wdevbox/synthtar/synth-drawing-4-19-19.PNG

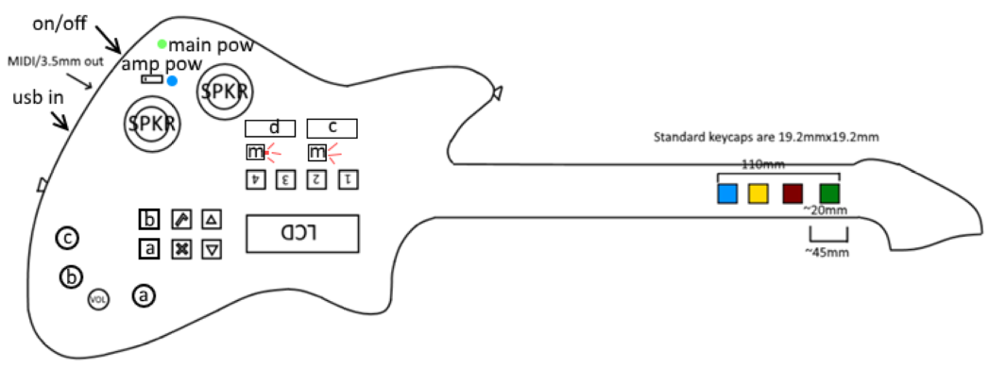
synth-drawing-4-19-19.PNG
