wdevbox/synthtar/Synthtar/Images/overall_schematic.png

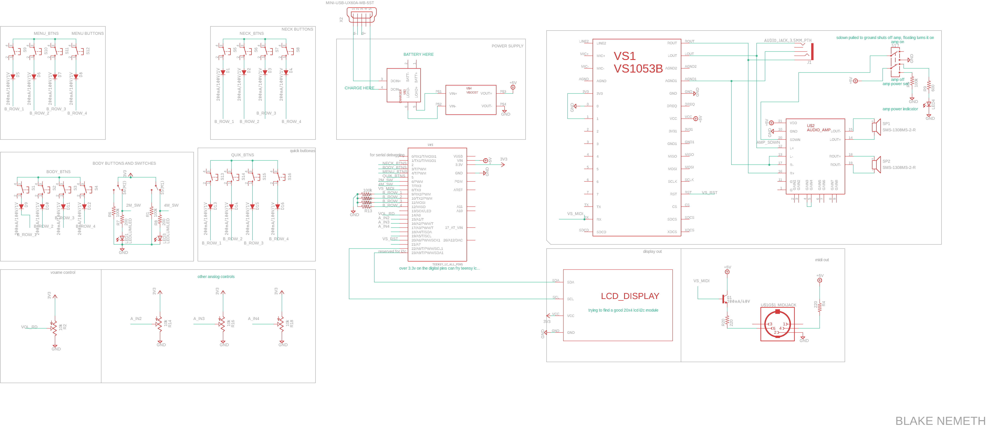
Synthtar/Images/overall_schematic.png
