wdevbox/synthtar/Synthtar/Images/schem_4-19-19-morning.png

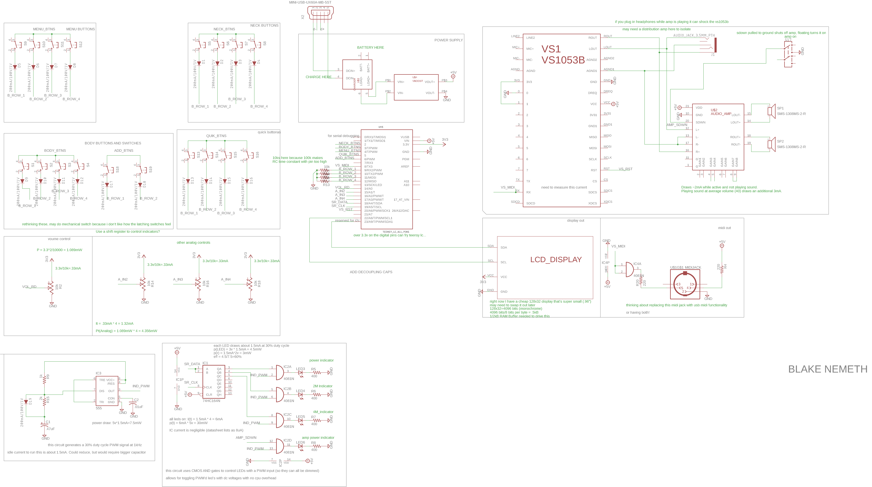
Synthtar/Images/schem_4-19-19-morning.png
