wdevbox/synthtar/Synthtar/analog_inputs.brd

## EAGLE design Synthtar/analog_inputs.brd (2019-05-16)

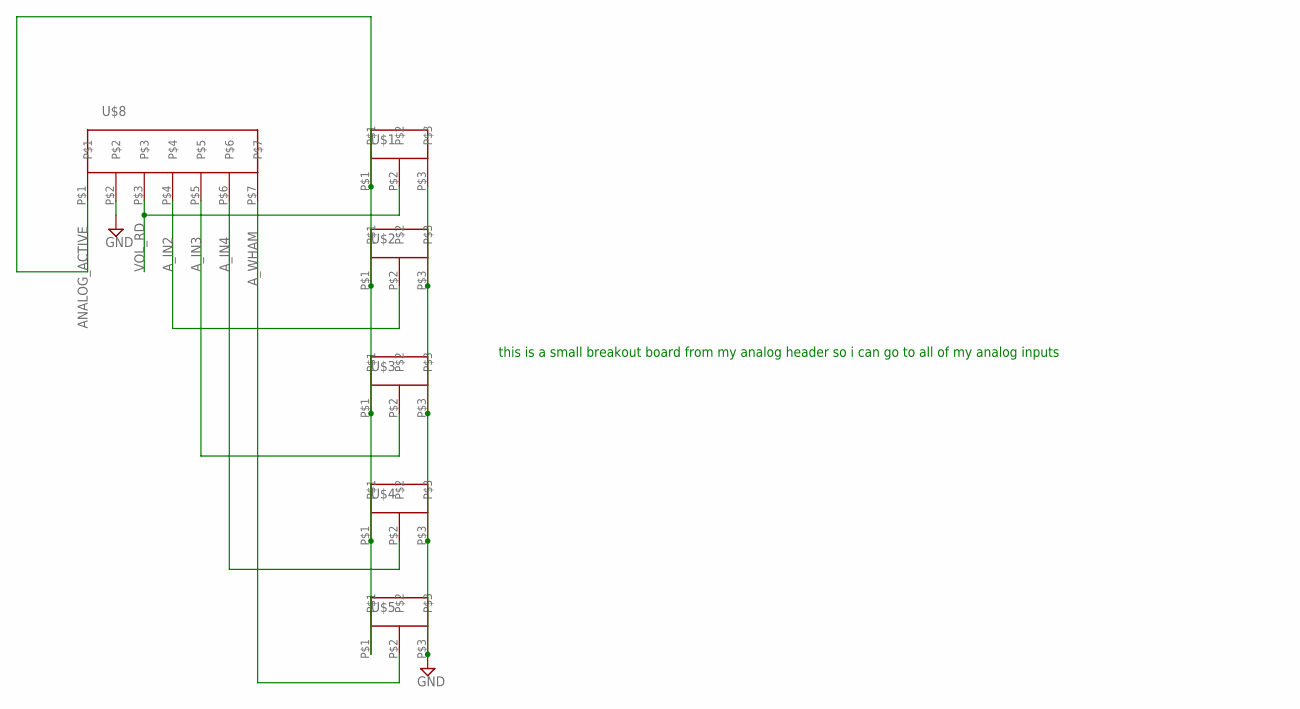
[picture p27: schematic analog_inputs.sch]

Parts:
U$1, U$2, U$3, U$4, U$5: 3-PIN-HEADER
U$8: 7-PIN-HEADER

Connections:
ANALOG_ACTIVE: U$1.P$1, U$2.P$1, U$3.P$1, U$4.P$1, U$5.P$1, U$8.P$1
A_IN2: U$2.P$2, U$8.P$4
A_IN3: U$3.P$2, U$8.P$5
A_IN4: U$4.P$2, U$8.P$6
A_WHAM: U$5.P$2, U$8.P$7
GND: U$1.P$3, U$2.P$3, U$3.P$3, U$4.P$3, U$5.P$3, U$8.P$2
VOL_RD: U$1.P$2, U$8.P$3

Notes on the sheet:
this is a small breakout board from my analog header so i can go to all of my analog inputs

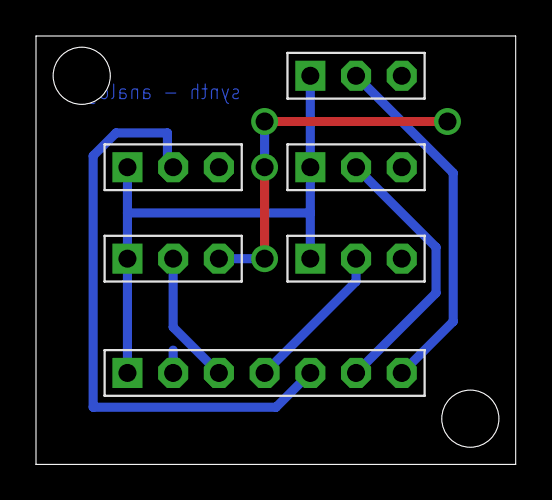
[picture p28: board analog_inputs.brd from above]

Board: 2 copper layers, 26.7 x 23.8 mm, 6 parts (0 on the bottom side), 7 nets.
