wdevbox/synthtar/Synthtar/motherboard.brd

## EAGLE design Synthtar/motherboard.brd (2019-05-06)

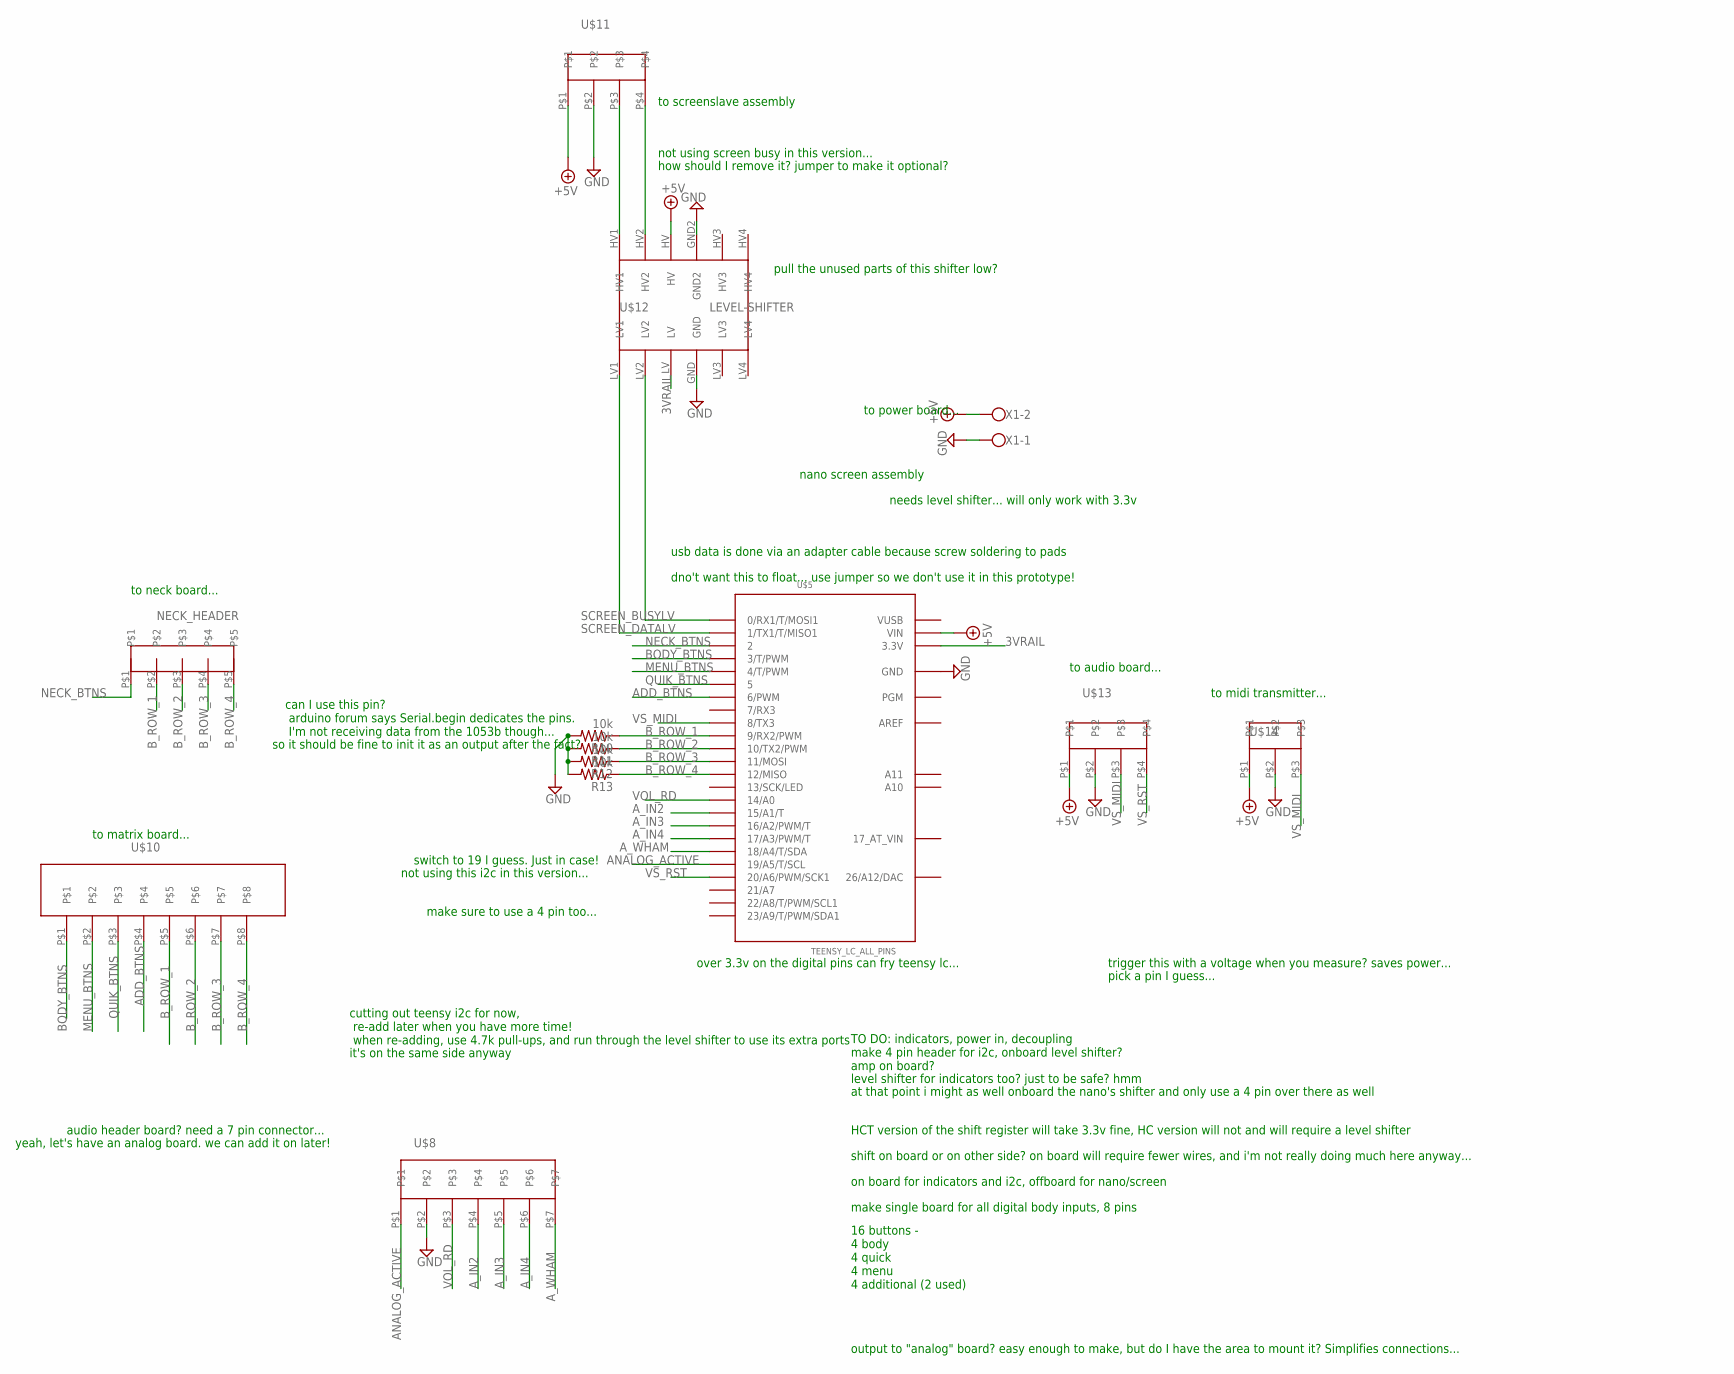
[picture p29: schematic motherboard.sch]

Parts:
NECK_HEADER: 5-PIN-HEADER
R10, R11, R12, R13: 10k; 0204/7
U$5: TEENSY_LC_ALL_PINS; TEENSY_3.0-3.2&LC_ALL_PINS
U$8: 7-PIN-HEADER
U$10: 8-PIN-HEADER
U$11, U$13: 4-PIN-HEADER
U$12: LEVEL-SHIFTER
U$14: 3-PIN-HEADER
X1: W237-102

Connections:
3VRAIL: U$5.3.3V, U$5.3.3V1 (3.3V), U$12.LV
26/A12/DAC: U$5.RESET/DAC (26/A12/DAC)
+5V: U$5.VIN, U$11.P$1, U$12.HV, U$13.P$1, U$14.P$1, X1.2
ADD_BTNS: U$5.6 (6/PWM), U$10.P$4
ANALOG_ACTIVE: U$5.19/A5 (19/A5/T/SCL), U$8.P$1
AREF: U$5.AREF
A_IN2: U$5.15/A1 (15/A1/T), U$8.P$4
A_IN3: U$5.16/A2 (16/A2/PWM/T), U$8.P$5
A_IN4: U$5.17/A3 (17/A3/PWM/T), U$8.P$6
A_WHAM: U$5.18/A4 (18/A4/T/SDA), U$8.P$7
BODY_BTNS: U$5.3 (3/T/PWM), U$10.P$1
B_ROW_1: NECK_HEADER.P$2, R10.1, U$5.9 (9/RX2/PWM), U$10.P$5
B_ROW_2: NECK_HEADER.P$3, R11.1, U$5.10 (10/TX2/PWM), U$10.P$6
B_ROW_3: NECK_HEADER.P$4, R12.1, U$5.11 (11/MOSI), U$10.P$7
B_ROW_4: NECK_HEADER.P$5, R13.1, U$5.12 (12/MISO), U$10.P$8
GND: R10.2, R11.2, R12.2, R13.2, U$5.AGND (GND), U$5.GND, U$5.GND1 (GND), U$8.P$2, U$11.P$2, U$12.GND, U$12.GND2, U$13.P$2, U$14.P$2, X1.1
MENU_BTNS: U$5.4 (4/T/PWM), U$10.P$2
unnamed: U$11.P$3, U$12.HV1
unnamed: U$11.P$4, U$12.HV2
NECK_BTNS: NECK_HEADER.P$1, U$5.2
QUIK_BTNS: U$5.5, U$10.P$3
SCREEN_BUSYLV: U$5.0 (0/RX1/T/MOSI1), U$12.LV2
SCREEN_DATALV: U$5.1 (1/TX1/T/MISO1), U$12.LV1
VOL_RD: U$5.14/A0, U$8.P$3
VS_MIDI: U$5.8 (8/TX3), U$13.P$3, U$14.P$3
VS_RST: U$5.20/A6 (20/A6/PWM/SCK1), U$13.P$4
VUSB: U$5.VUSB

Notes on the sheet:
over 3.3v on the digital pins can fry teensy lc...
nano screen assembly
TO DO: indicators, power in, decoupling make 4 pin header for i2c, onboard level shifter? amp on board?
level shifter for indicators too? just to be safe? hmm
at that point i might as well onboard the nano's shifter and only use a 4 pin over there as well
HCT version of the shift register will take 3.3v fine, HC version will not and will require a level shifter
shift on board or on other side? on board will require fewer wires, and i'm not really doing much here anyway...
needs level shifter... will only work with 3.3v
on board for indicators and i2c, offboard for nano/screen
make single board for all digital body inputs, 8 pins
16 buttons - 4 body 4 quick 4 menu 4 additional (2 used)
output to "analog" board? easy enough to make, but do I have the area to mount it? Simplifies connections...
to matrix board...
to neck board...
to power board...
to audio board...
to midi transmitter...
usb data is done via an adapter cable because screw soldering to pads
to screenslave assembly
not using screen busy in this version...
how should I remove it? jumper to make it optional?
pull the unused parts of this shifter low?
dno't want this to float... use jumper so we don't use it in this prototype!
not using this i2c in this version...
audio header board? need a 7 pin connector...
yeah, let's have an analog board. we can add it on later!
trigger this with a voltage when you measure? saves power...
pick a pin I guess...
can I use this pin? arduino forum says Serial.begin dedicates the pins. I'm not receiving data from the 1053b though...
so it should be fine to init it as an output after the fact?
switch to 19 I guess. Just in case!
cutting out teensy i2c for now, re-add later when you have more time! when re-adding, use 4.7k pull-ups, and run through the level shifter to use its extra ports
it's on the same side anyway
make sure to use a 4 pin too...

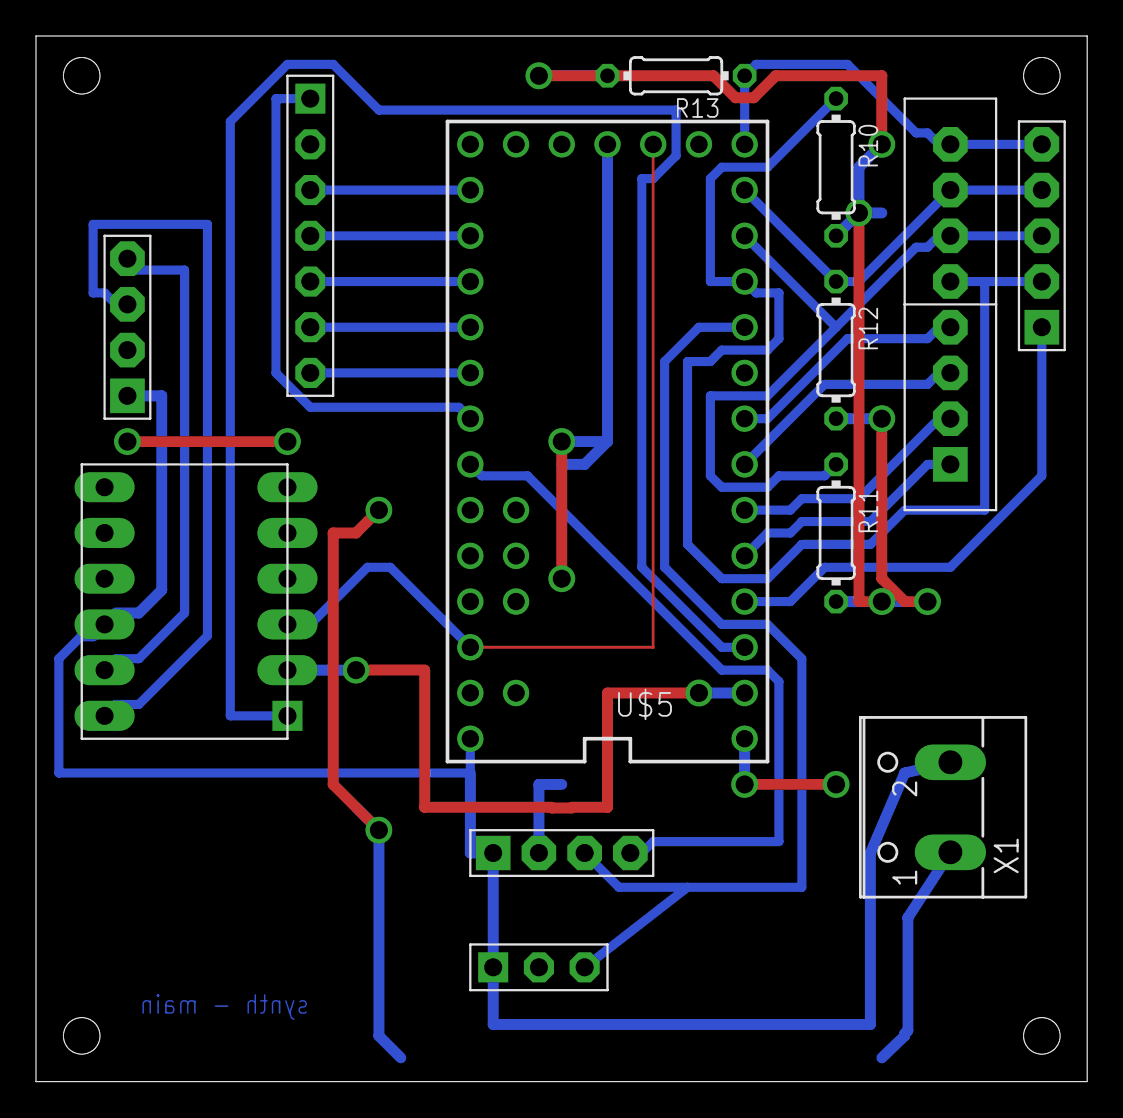
[picture p30: board motherboard.brd from above]

Board: 2 copper layers, 58.4 x 58.1 mm, 13 parts (0 on the bottom side), 24 nets.
