wdevbox/synthtar/Synthtar/audio_board.brd

## EAGLE design Synthtar/audio_board.brd (2019-05-06)

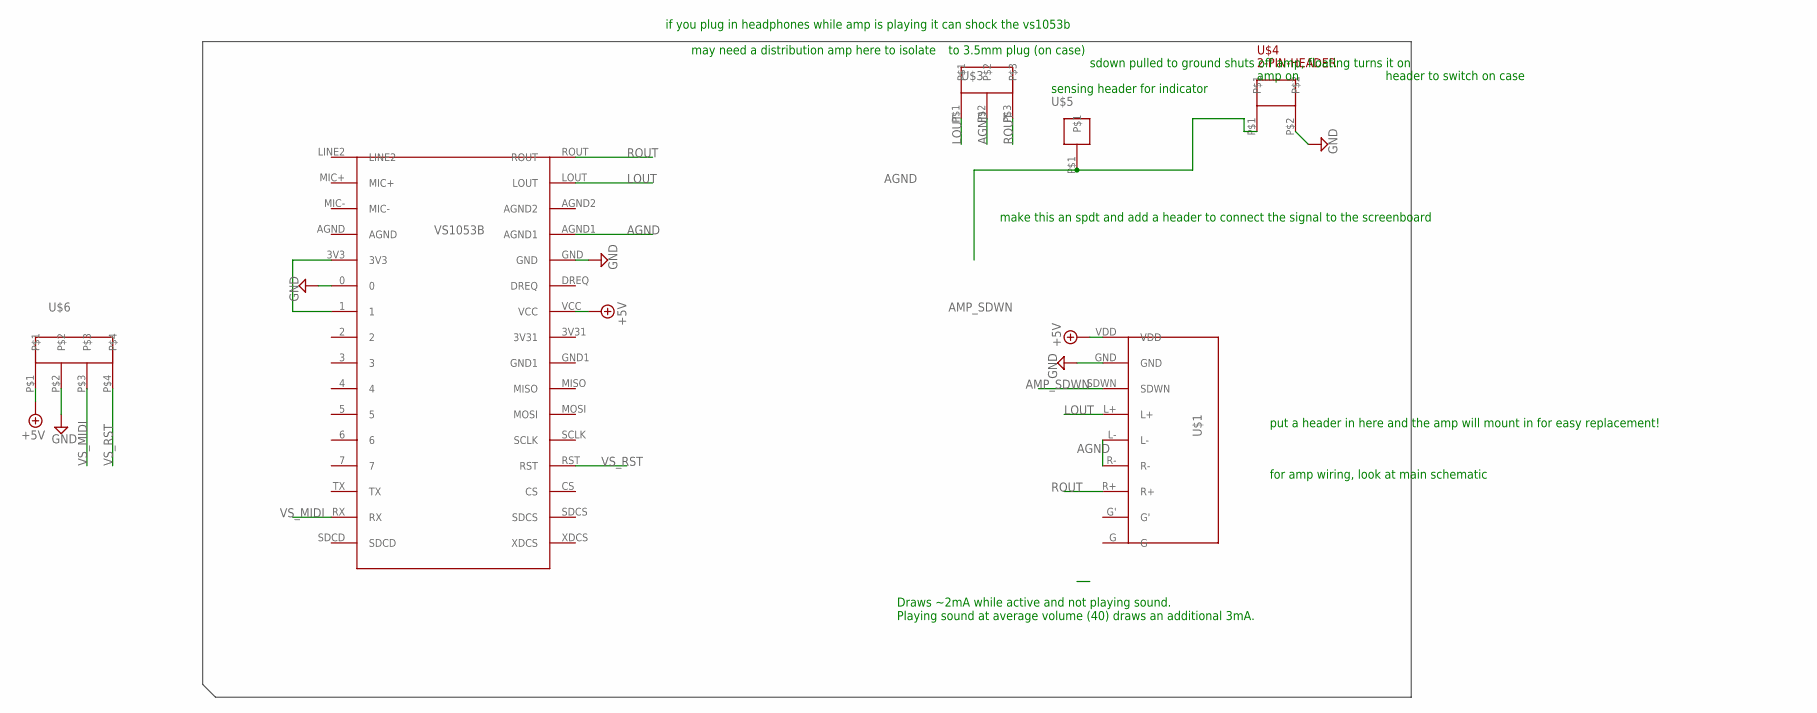
[picture p31: schematic audio_board.sch]

Parts:
U$1: AUDIOAMP
U$3: 3-PIN-HEADER
U$4: 2-PIN-HEADER
U$5: 1-PIN-HEADER
U$6: 4-PIN-HEADER
VS1053B: VS1053B

Connections:
+5V: U$1.VDD, U$6.P$1, VS1053B.VCC
AGND: U$1.L-, U$1.R-, U$3.P$2, VS1053B.AGND1
AMP_SDWN: U$1.SDWN, U$4.P$1, U$5.P$1
GND: U$1.GND, U$4.P$2, U$6.P$2, VS1053B.0, VS1053B.GND
LOUT: U$1.L+, U$3.P$1, VS1053B.LOUT
unnamed: VS1053B.1, VS1053B.3V3
ROUT: U$1.R+, U$3.P$3, VS1053B.ROUT
VS_MIDI: U$6.P$3, VS1053B.RX
VS_RST: U$6.P$4, VS1053B.RST

Notes on the sheet:
amp on
sdown pulled to ground shuts off amp, floating turns it on
Draws ~2mA while active and not playing sound. Playing sound at average volume (40) draws an additional 3mA.
may need a distribution amp here to isolate
if you plug in headphones while amp is playing it can shock the vs1053b
make this an spdt and add a header to connect the signal to the screenboard
to 3.5mm plug (on case)
header to switch on case
sensing header for indicator
put a header in here and the amp will mount in for easy replacement!
for amp wiring, look at main schematic

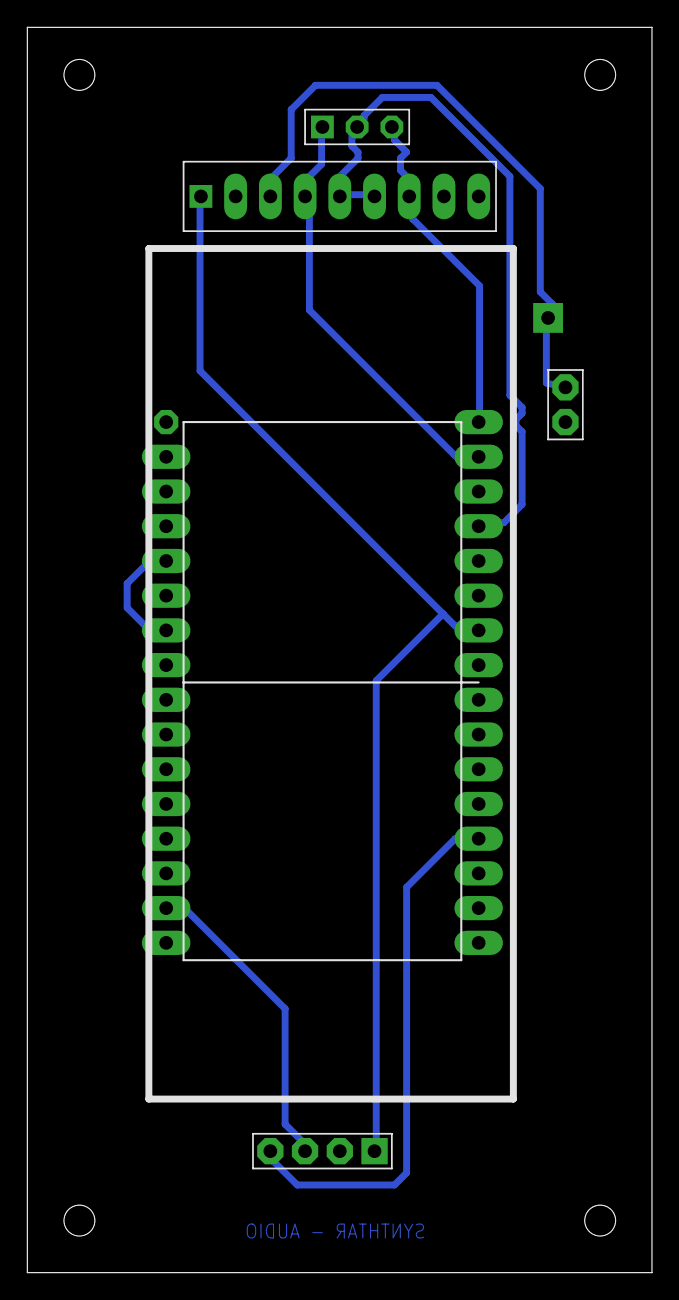
[picture p32: board audio_board.brd from above]

Board: 2 copper layers, 45.7 x 91.1 mm, 6 parts (0 on the bottom side), 9 nets.
