wdevbox/synthtar/Synthtar/ind_output.brd

## EAGLE design Synthtar/ind_output.brd (2019-05-03)

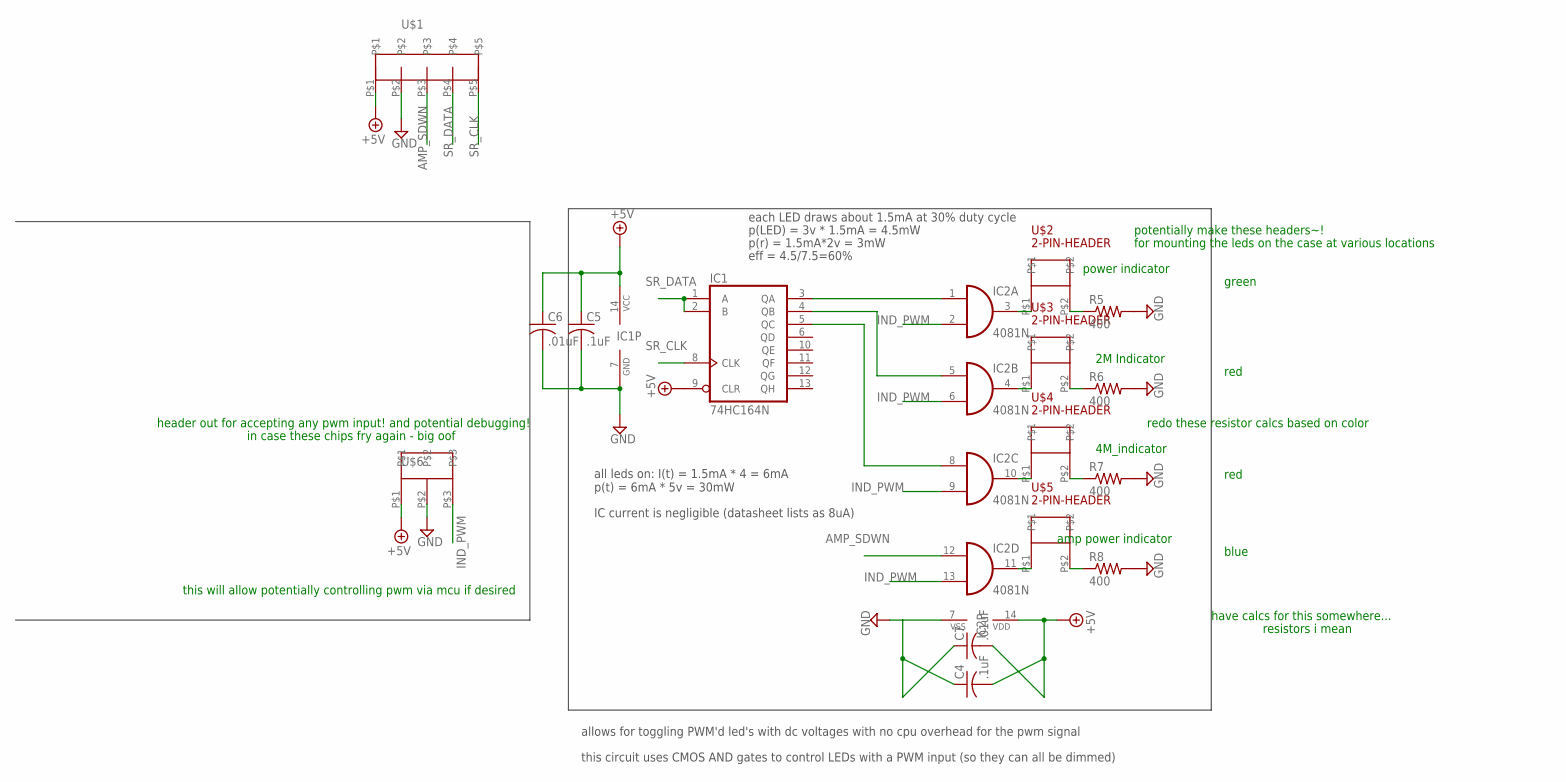
[picture p33: schematic ind_output.sch]

Parts:
C4, C5: .1uF; C025-030X050
C6, C7: .01uF; C025-030X050
IC1: 74HC164N; DIL14
IC2: 4081N; DIL14
R5, R6, R7, R8: 400; 0204/7
U$1: 5-PIN-HEADER
U$2, U$3, U$4, U$5: 2-PIN-HEADER
U$6: 3-PIN-HEADER

Connections:
+5V: C4.2, C5.1, C6.1, C7.2, IC1.9 (CLR), IC1.14 (VCC), IC2.14 (VDD), U$1.P$1, U$6.P$1
AMP_SDWN: IC2.12 (I0), U$1.P$3
GND: C4.1, C5.2, C6.2, C7.1, IC1.7 (GND), IC2.7 (VSS), R5.2, R6.2, R7.2, R8.2, U$1.P$2, U$6.P$2
IND_PWM: IC2.2 (I1), IC2.6 (I1), IC2.9 (I1), IC2.13 (I1), U$6.P$3
unnamed: IC1.3 (QA), IC2.1 (I0)
unnamed: IC1.4 (QB), IC2.5 (I0)
unnamed: IC2.3 (O), U$2.P$1
unnamed: IC1.5 (QC), IC2.8 (I0)
unnamed: R5.1, U$2.P$2
unnamed: IC2.4 (O), U$3.P$1
unnamed: R6.1, U$3.P$2
unnamed: IC2.10 (O), U$4.P$1
unnamed: R7.1, U$4.P$2
unnamed: IC2.11 (O), U$5.P$1
unnamed: R8.1, U$5.P$2
SR_CLK: IC1.8 (CLK), U$1.P$5
SR_DATA: IC1.1 (A), IC1.2 (B), U$1.P$4

Notes on the sheet:
amp power indicator
2M Indicator
4M_indicator
power indicator
this circuit uses CMOS AND gates to control LEDs with a PWM input (so they can all be dimmed)
allows for toggling PWM'd led's with dc voltages with no cpu overhead for the pwm signal
each LED draws about 1.5mA at 30% duty cycle
p(LED) = 3v * 1.5mA = 4.5mW
p(r) = 1.5mA*2v = 3mW
eff = 4.5/7.5=60%
all leds on: I(t) = 1.5mA * 4 = 6mA p(t) = 6mA * 5v = 30mW
IC current is negligible (datasheet lists as 8uA)
potentially make these headers~!
for mounting the leds on the case at various locations
redo these resistor calcs based on color
green
blue
red
have calcs for this somewhere...
resistors i mean
header out for accepting any pwm input! and potential debugging!
in case these chips fry again - big oof
this will allow potentially controlling pwm via mcu if desired

Board: 2 copper layers, 16 parts (0 on the bottom side), 17 nets, no tracks yet.
