wdevbox/synthtar/Synthtar/matrix_buttons_body.brd

## EAGLE design Synthtar/matrix_buttons_body.brd (2019-05-03)

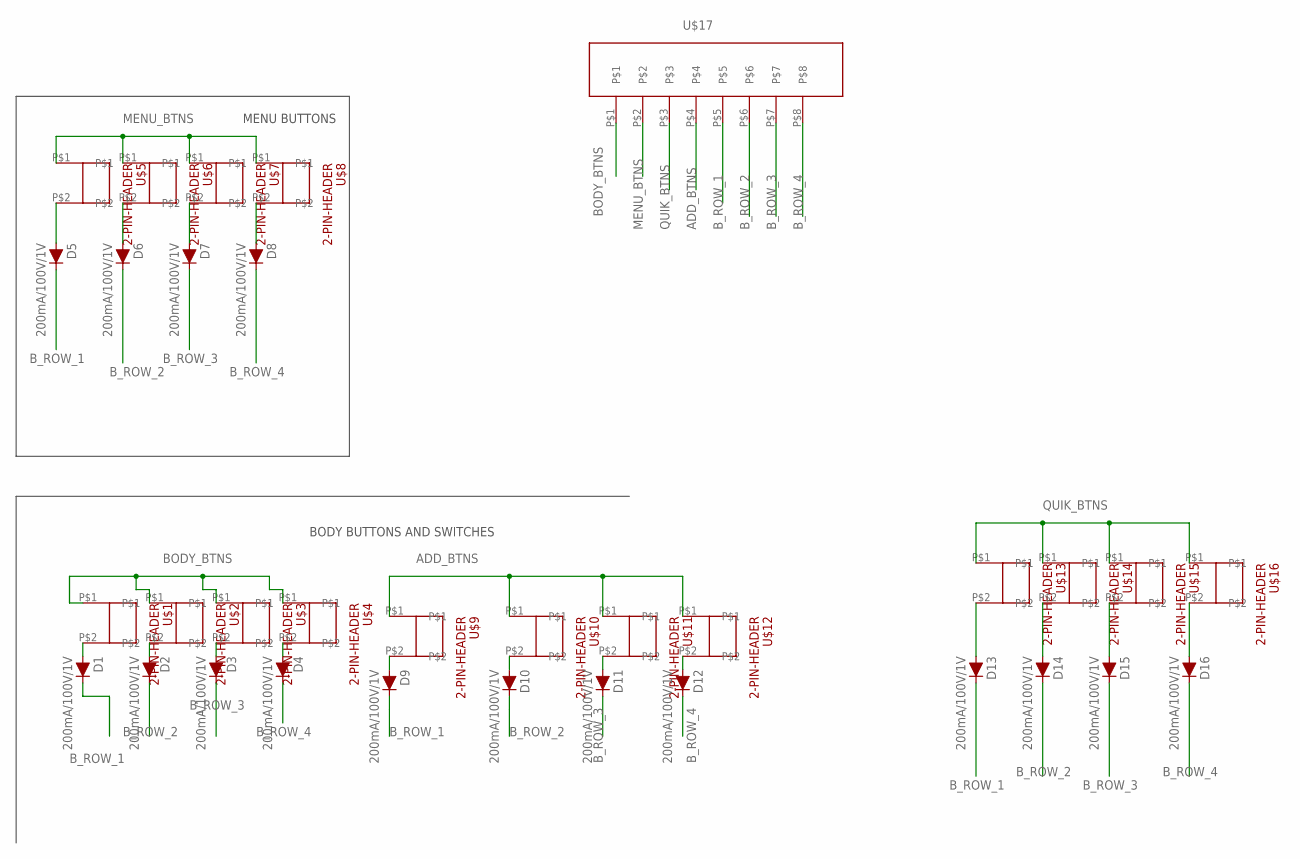
[picture p34: schematic matrix_buttons_body.sch]

Parts:
D1, D2, D3, D4, D5, D6, D7, D8, D9, D10, D11, D12, D13, D14, D15, D16: 200mA/100V/1V; DIODE-1N4148
U$1, U$2, U$3, U$4, U$5, U$6, U$7, U$8, U$9, U$10, U$11, U$12, U$13, U$14, U$15, U$16: 2-PIN-HEADER
U$17: 8-PIN-HEADER

Connections:
ADD_BTNS: U$9.P$1, U$10.P$1, U$11.P$1, U$12.P$1, U$17.P$4
BODY_BTNS: U$1.P$1, U$2.P$1, U$3.P$1, U$4.P$1, U$17.P$1
B_ROW_1: D1.C, D5.C, D9.C, D13.C, U$17.P$5
B_ROW_2: D2.C, D6.C, D10.C, D14.C, U$17.P$6
B_ROW_3: D3.C, D7.C, D11.C, D15.C, U$17.P$7
B_ROW_4: D4.C, D8.C, D12.C, D16.C, U$17.P$8
MENU_BTNS: U$5.P$1, U$6.P$1, U$7.P$1, U$8.P$1, U$17.P$2
unnamed: D11.A, U$11.P$2
unnamed: D12.A, U$12.P$2
unnamed: D9.A, U$9.P$2
unnamed: D10.A, U$10.P$2
unnamed: D5.A, U$5.P$2
unnamed: D6.A, U$6.P$2
unnamed: D7.A, U$7.P$2
unnamed: D8.A, U$8.P$2
unnamed: D1.A, U$1.P$2
unnamed: D2.A, U$2.P$2
unnamed: D3.A, U$3.P$2
unnamed: D4.A, U$4.P$2
unnamed: D13.A, U$13.P$2
unnamed: D14.A, U$14.P$2
unnamed: D15.A, U$15.P$2
unnamed: D16.A, U$16.P$2
QUIK_BTNS: U$13.P$1, U$14.P$1, U$15.P$1, U$16.P$1, U$17.P$3

Notes on the sheet:
BODY BUTTONS AND SWITCHES
MENU BUTTONS

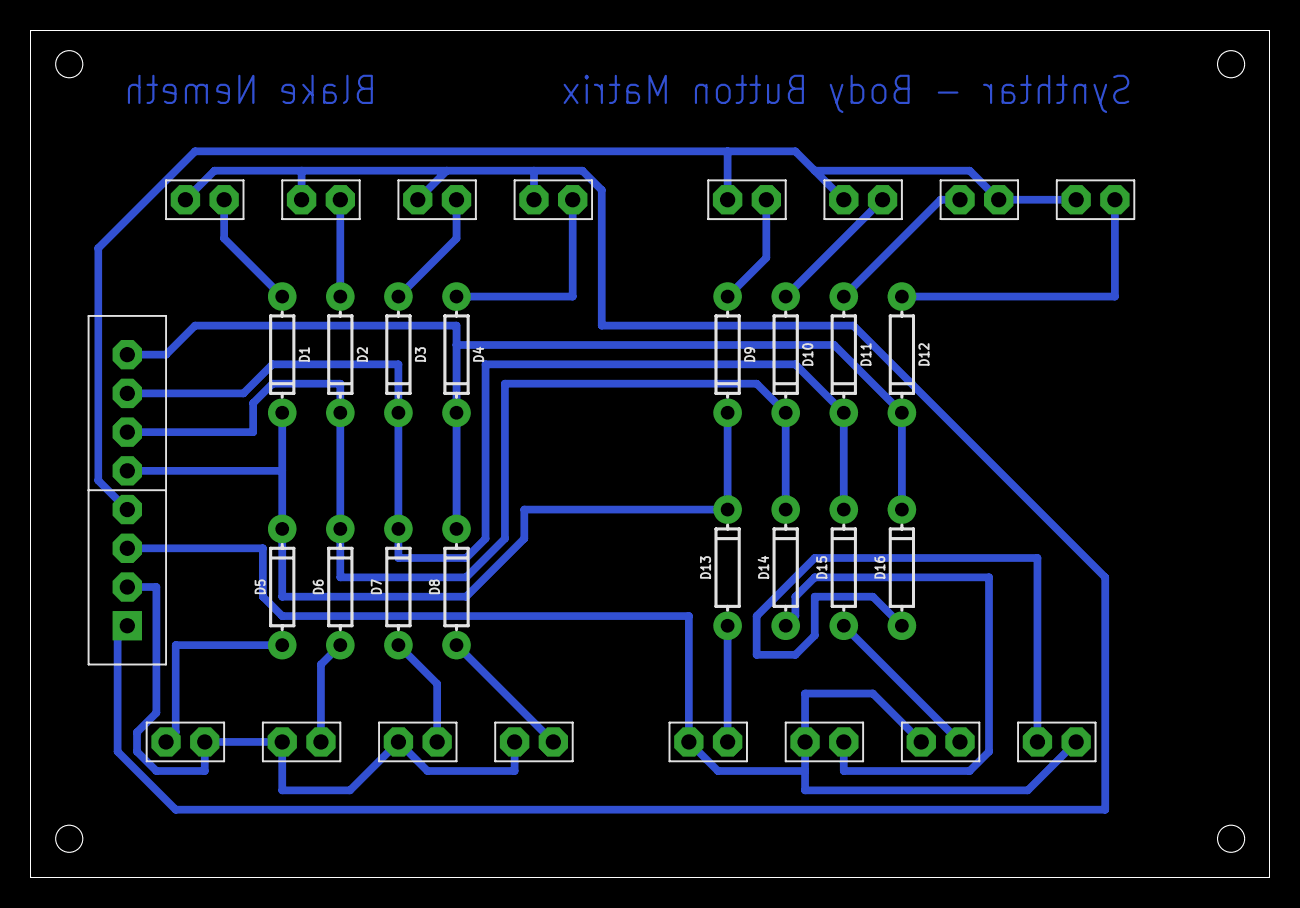
[picture p35: board matrix_buttons_body.brd from above]

Board: 2 copper layers, 81.3 x 55.5 mm, 33 parts (0 on the bottom side), 24 nets.
