wdevbox/synthtar/Synthtar/midi_transmitter.brd

## EAGLE design Synthtar/midi_transmitter.brd (2019-04-24)

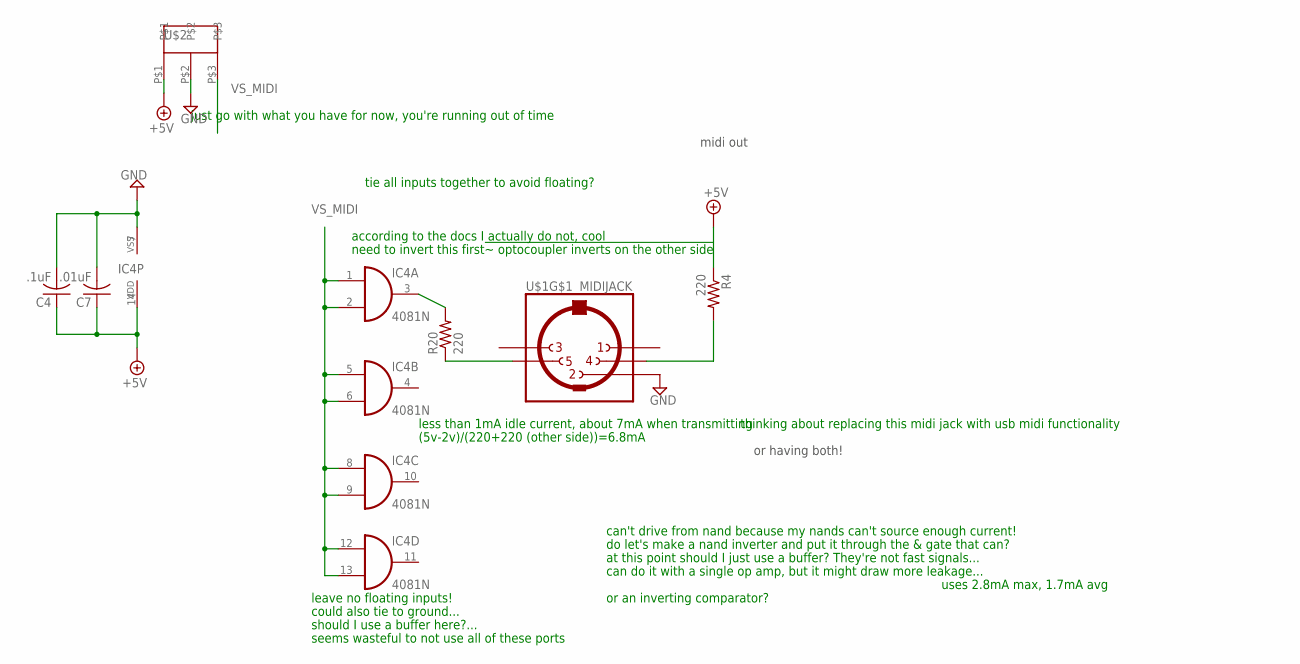
[picture p36: schematic midi_transmitter.sch]

Parts:
C4: .1uF; C025-030X050
C7: .01uF; C025-030X050
IC4: 4081N; DIL14
R4, R20: 220; 0204/7
U$1: MIDIJACK; CP-2350
U$2: 3-PIN-HEADER

Connections:
+5V: C4.1, C7.1, IC4.14 (VDD), R4.1, U$2.P$1
GND: C4.2, C7.2, IC4.7 (VSS), U$1.2, U$2.P$2
unnamed: IC4.3 (O), R20.2
unnamed: R4.2, U$1.4
unnamed: R20.1, U$1.5
VS_MIDI: IC4.1 (I0), IC4.2 (I1), IC4.5 (I0), IC4.6 (I1), IC4.8 (I0), IC4.9 (I1), IC4.12 (I0), IC4.13 (I1), U$2.P$3

Notes on the sheet:
midi out
thinking about replacing this midi jack with usb midi functionality
or having both!
need to invert this first!~ optocoupler inverts on the other side
tie all inputs together to avoid floating?
can't drive from nand because my nands can't source enough current!
do let's make a nand inverter and put it through the & gate that can?
at this point should I just use a buffer? They're not fast signals...
can do it with a single op amp, but it might draw more leakage...
or an inverting comparator?
uses 2.8mA max, 1.7mA avg
just go with what you have for now, you're running out of time
according to the docs I actually do not, cool
less than 1mA idle current, about 7mA when transmitting
(5v-2v)/(220+220 (other side))=6.8mA
leave no floating inputs!
could also tie to ground...
should I use a buffer here?...
seems wasteful to not use all of these ports

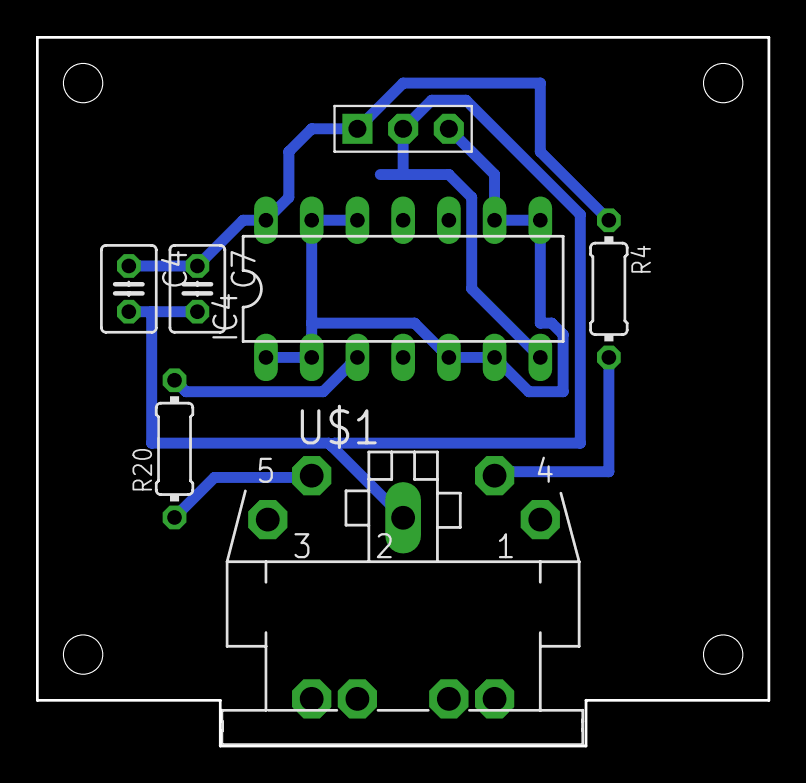
[picture p37: board midi_transmitter.brd from above]

Board: 2 copper layers, 40.6 x 39.4 mm, 7 parts (0 on the bottom side), 6 nets.
