wdevbox/synthtar/Synthtar/neck_assembly.brd

## EAGLE design Synthtar/neck_assembly.brd (2019-04-22)

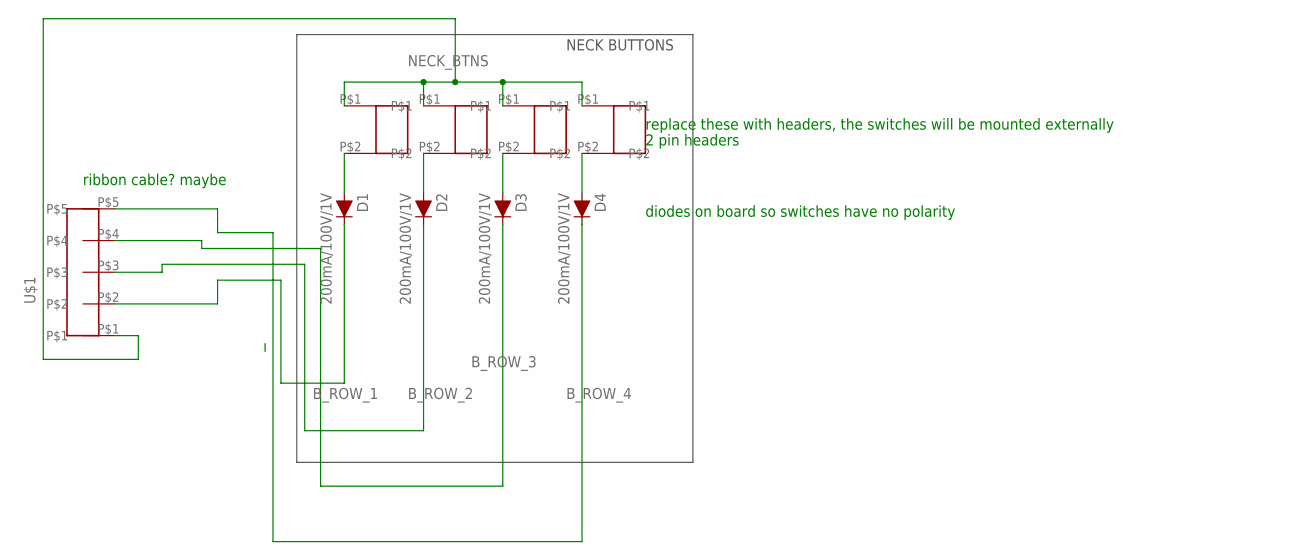
[picture p38: schematic neck_assembly.sch]

Parts:
B1, B2, B3, B4: 2-PIN-HEADER
D1, D2, D3, D4: 200mA/100V/1V; DIODE-1N4148
U$1: 5-PIN-HEADER

Connections:
B_ROW_1: D1.C, U$1.P$2
B_ROW_2: D2.C, U$1.P$3
B_ROW_3: D3.C, U$1.P$4
B_ROW_4: D4.C, U$1.P$5
unnamed: B1.P$2, D1.A
unnamed: B2.P$2, D2.A
unnamed: B3.P$2, D3.A
unnamed: B4.P$2, D4.A
NECK_BTNS: B1.P$1, B2.P$1, B3.P$1, B4.P$1, U$1.P$1

Notes on the sheet:
NECK BUTTONS
replace these with headers, the switches will be mounted externally
2 pin headers
diodes on board so switches have no polarity
ribbon cable? maybe

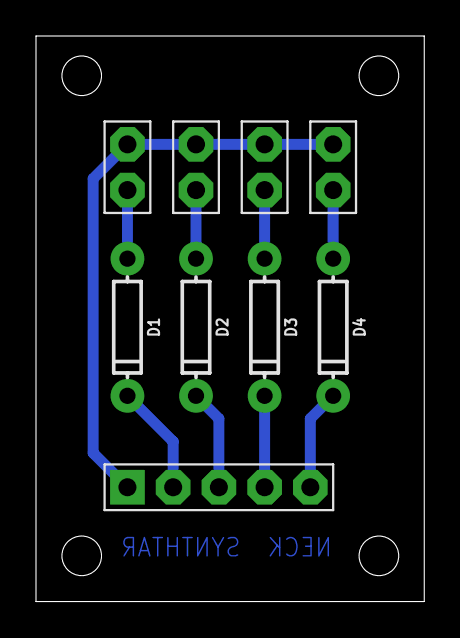
[picture p39: board neck_assembly.brd from above]

Board: 2 copper layers, 21.6 x 31.4 mm, 9 parts (0 on the bottom side), 9 nets.
