wdevbox/synthtar/Synthtar/musb-input-breakout.brd

## EAGLE design Synthtar/musb-input-breakout.brd (2019-05-09)

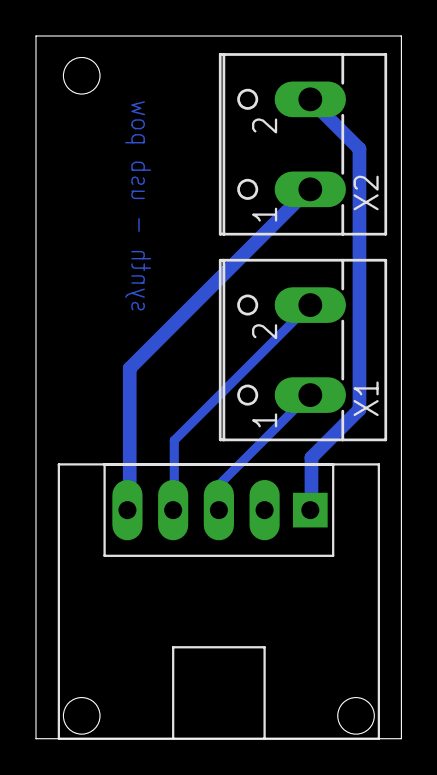
[picture p40: board musb-input-breakout.brd from above]

Board: 2 copper layers, 20.3 x 39.0 mm, 3 parts (0 on the bottom side), 4 nets.

Parts:
U$1: MICRO-USB
X1, X2: W237-102

Connections:
unnamed: U$1.GND, X2.2
unnamed: U$1.5V, X2.1
unnamed: U$1.D+, X1.1
unnamed: U$1.D-, X1.2
