wdevbox/synthtar/Synthtar/screenSlavevOther.brd

## EAGLE design Synthtar/screenSlavevOther.brd (2019-05-03)

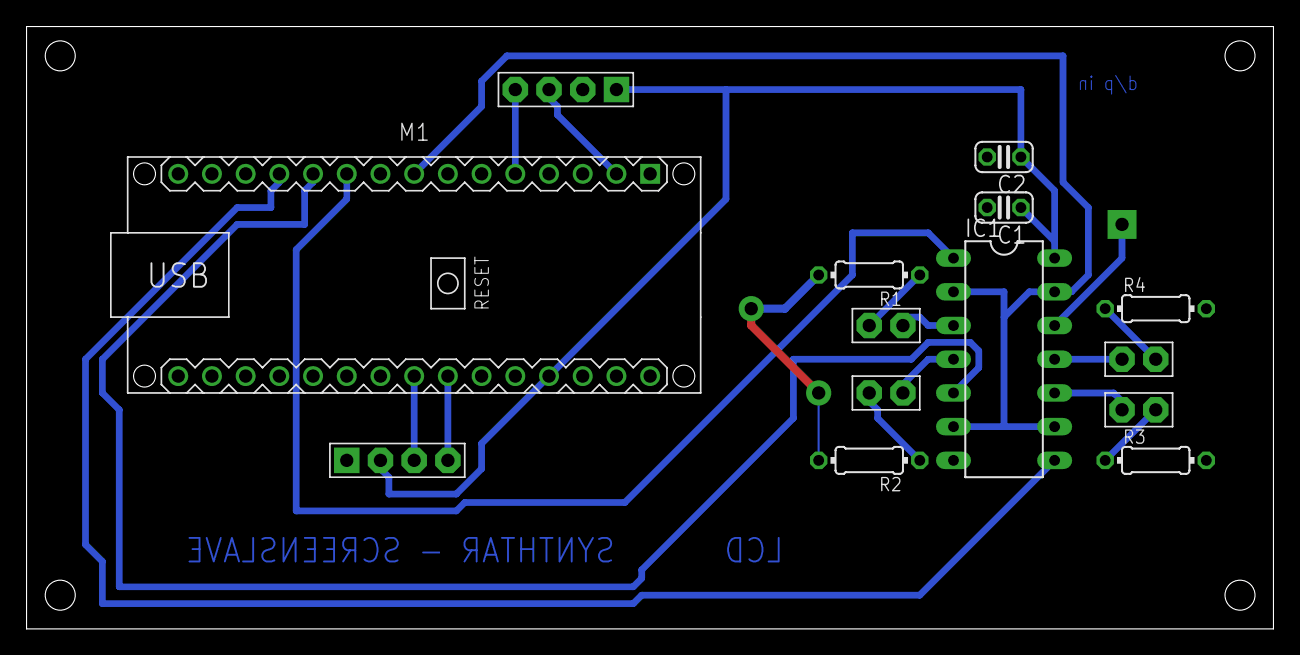
[picture p41: board screenSlavevOther.brd from above]

Board: 2 copper layers, 94.0 x 45.4 mm, 15 parts (0 on the bottom side), 19 nets.

Parts:
C1: .01uF; C025-024X044
C2: .1uF; C025-024X044
IC1: 4081N; DIL14
M1: ARDUINO-NANO-3.0
R1, R2, R3, R4: 400; 0204/7
U$1, U$2: 4-PIN-HEADER
U$3: 1-PIN-HEADER
U$4, U$5, U$6, U$7: 2-PIN-HEADER

Connections:
+5V: C1.1, C2.1, IC1.14, M1.J2.4, U$1.P$1, U$2.P$2
BUSY_OUT: M1.J1.5, U$1.P$4
DATA_IN: M1.J1.2, U$1.P$3
GND: C1.2, C2.2, IC1.7, M1.J2.2, R1.2, R2.2, R3.2, R4.2, U$1.P$2, U$2.P$1
unnamed: IC1.12, U$3.P$1
unnamed: IC1.11, U$7.P$1
unnamed: IC1.3, U$4.P$1
unnamed: R1.1, U$4.P$2
unnamed: IC1.4, U$5.P$1
unnamed: IC1.10, U$6.P$1
unnamed: R3.1, U$6.P$2
unnamed: IC1.1, M1.J1.10
unnamed: R2.1, U$5.P$2
unnamed: IC1.5, M1.J1.11
unnamed: IC1.8, M1.J1.12
unnamed: R4.1, U$7.P$2
SCL: M1.J2.7, U$2.P$4
SDA: M1.J2.8, U$2.P$3
SIG_PWM: IC1.2, IC1.6, IC1.9, IC1.13, M1.J1.8
