wdevbox/synthtar/Synthtar/Adafruit VS1053 Breakout.brd

## EAGLE design Synthtar/Adafruit VS1053 Breakout.brd (2019-04-20)

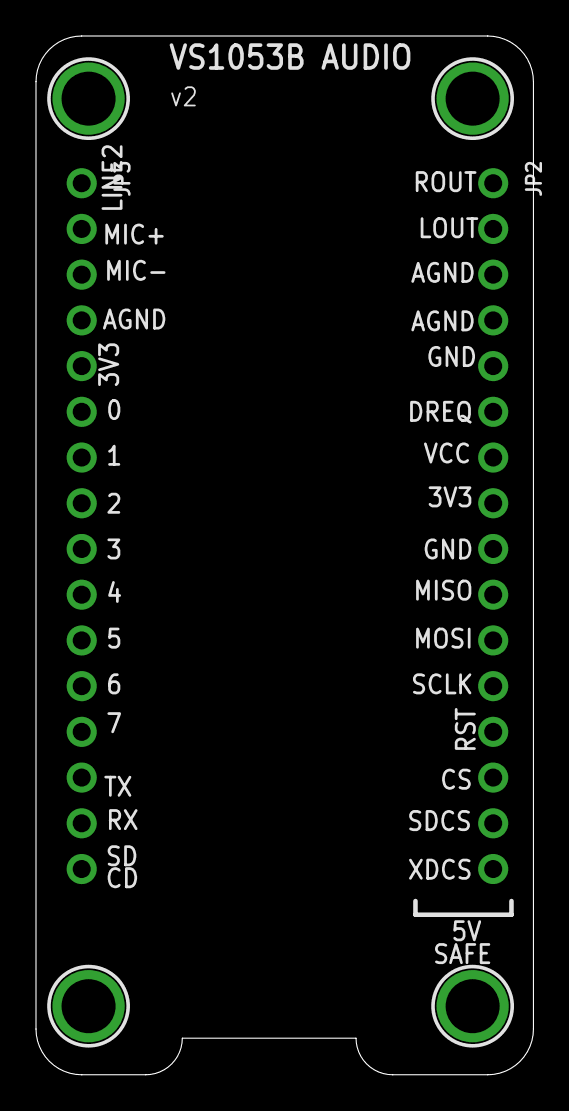
[picture p42: board Adafruit VS1053 Breakout.brd from above]

Board: 2 copper layers, 27.6 x 57.7 mm, 7 parts (1 on the bottom side), 2 nets, no tracks yet.

Parts:
JP2, JP3: 1X16_ROUND
U$50, U$51, U$52, U$53: MOUNTINGHOLE3.0THIN; MOUNTINGHOLE_3.0_PLATEDTHIN
U$55: ADAFRUIT_TEXT_20MM

Connections:
AGND: JP2.3, JP2.4
GND: JP2.5, JP2.9
