wdevbox/synthtar/(commit log)

2019-03-16 Create synth_button_matrix_test.ino
    Sort of works, when pressing buttons in col1, a: strings don't change note (they do if you press them while the string is playing?) b: one of the buttons reads as row1 for col2 as well. no idea why. it does it if you switch the wires to a different pin too. it's not the diodes. maybe it's the mcu pin
2019-03-16 Update synth_button_matrix_test.ino
    fixed changing not working when not pressed, some issue with the for each loop, didn't like it for some reason. changed it to a dumb for loop and now it works properly
    fixed button reading weird, it was either electrical noise or some capacitance/the diode not being able to charge fast enough. added a small delay before the first read of the next column and the issue is fixed.
    still need to fix the "losing notes" bug when you switch root while you're playing a chord, comments are in there
    [synth_button_matrix_test.ino]
2019-04-20 Schematics upload
    In the process of adding an additional circuit for a nano to control the LCD to save processing time from teensy, because I got a 16x2 LCD from the lab and it doesn't have SPI, only parallel.
    Country boys make do
    [Adafruit VS1053 Breakout.brd, mainboard.sch, mainboard_matrix.sch]
2019-04-20 excel sheets
    added some additional docs
    [ChordCombinations.xlsx, notes.xlsx]
2019-04-20 more uploads
    more recent files. code improvements
    [mainboard_matrix.sch]
2019-04-22 Board building
    started migrating overall schematic into individual boards
    [indicator_assembly.sch, mainboard_matrix.sch, neck_assembly.brd, neck_assembly.sch]
2019-04-22 indicator assembly
    finished indicator board
    [indicator_assembly.brd]
2019-04-22 Whammy Bar!
    Finally added whammy bar, an old ps3 analog stick
    [mainboard_matrix.sch]
2019-04-23 midi transmitter + lots of others
    midi transmitter board, main motherboard with headers to connect to everything else
    [mainboard_matrix.sch, midi_transmitter.brd, midi_transmitter.sch, motherboard.sch]
2019-04-24 joystick breakout for whammy
    created joystick breakout and added some more headers/notes to the mainboard
    [joystick.brd, joystick.sch, midi_transmitter.brd, motherboard.sch]
2019-04-25 indicator update
    honestly don't remmember what i changed, looks like added a header maybe?
    [indicator_assembly.sch]
2019-05-03 making boards and taking care of business
    honestly haven't made a commit in so fucking long
    [ind_output.brd, ind_output.sch, ind_pwm_gen.sch, matrix_buttons_body.brd, matrix_buttons_body.sch, screenSlave.brd, screenSlave.sch, screenSlavevOther.brd]
2019-05-06 big changes
    changed a ton
    [audio_board.brd, audio_board.sch, mainboard_matrix.sch, motherboard.sch]
2019-05-06 changed a_active to pin 19
    so it's not on a serial line. arduino forums said after Serial.begin() it becomes unpredictable
    [motherboard.sch]
2019-05-06 finished motherboard
    enough jumpers to fill a bad third eye blind playlist
    started making musb breakout for connecting power and data independently
    [motherboard.brd, motherboard.sch, musb-input-breakout.sch]
2019-05-09 so fucking much
    a
    [musb-input-breakout.brd, overall_schem.sch]
2019-05-16 misc changes
    misc updates while doing documentation
    [analog_inputs.brd, analog_inputs.sch, analog_inputs_long.brd, analog_inputs_long.sch, midi_transmitter.sch, neck_assembly.sch]
2019-05-16 added code for screenslave and main teensy
    also fixed some resistor values in overall schem
    [overall_schem.sch]
2019-05-16 deleted some comments
    deleted comments in midi trasmitter
    [midi_transmitter.sch]
2019-05-16 Update Users Manual - Synthtar.docx
    minor edits (still needs work, but i'm too tired)
